egeltje/sousvide-cooker/README.md

sousvide-cooker
===============

AVR atmega32 code for controlling a sous vide cooker. See http://www.ewak.net/blog/sous-vide-cooker/

NOTE: This code is no longer updated, since I got an Anova sous-vide cooker. This satisfies my needs for a cooker and I am no longer building my own.
