egeltje/sousvide-cooker/3d/sous-vide-display.stl

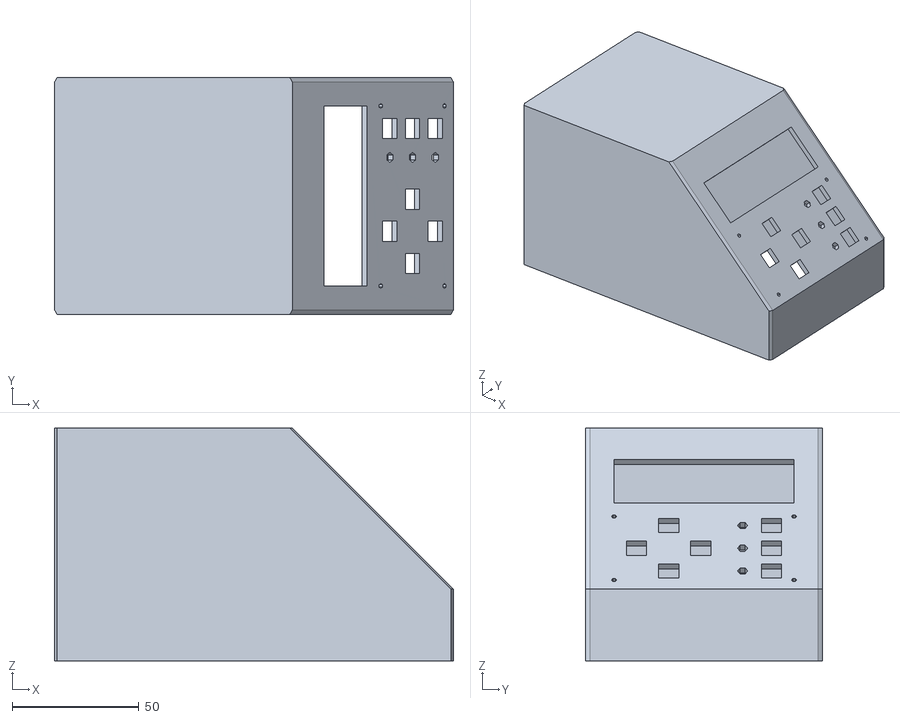
[picture p1: CAD file, 2014-01-03]
3d/sous-vide-display.stl
157.6 x 93.5 x 92.0
