egeltje/sousvide-cooker/3d/sous-vide-plug.stl

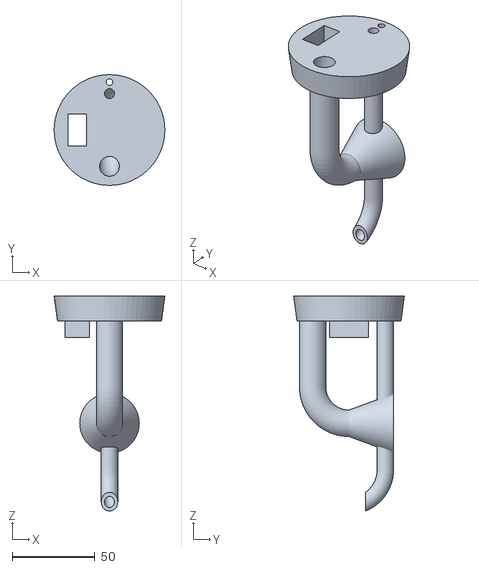
[picture p2: CAD file, 2014-01-01]
3d/sous-vide-plug.stl
67.0 x 67.0 x 130.0
