egeltje/sousvide-cooker/schematics/sous-vide_connect.brd

## EAGLE design schematics/sous-vide_connect.brd (2015-05-28)

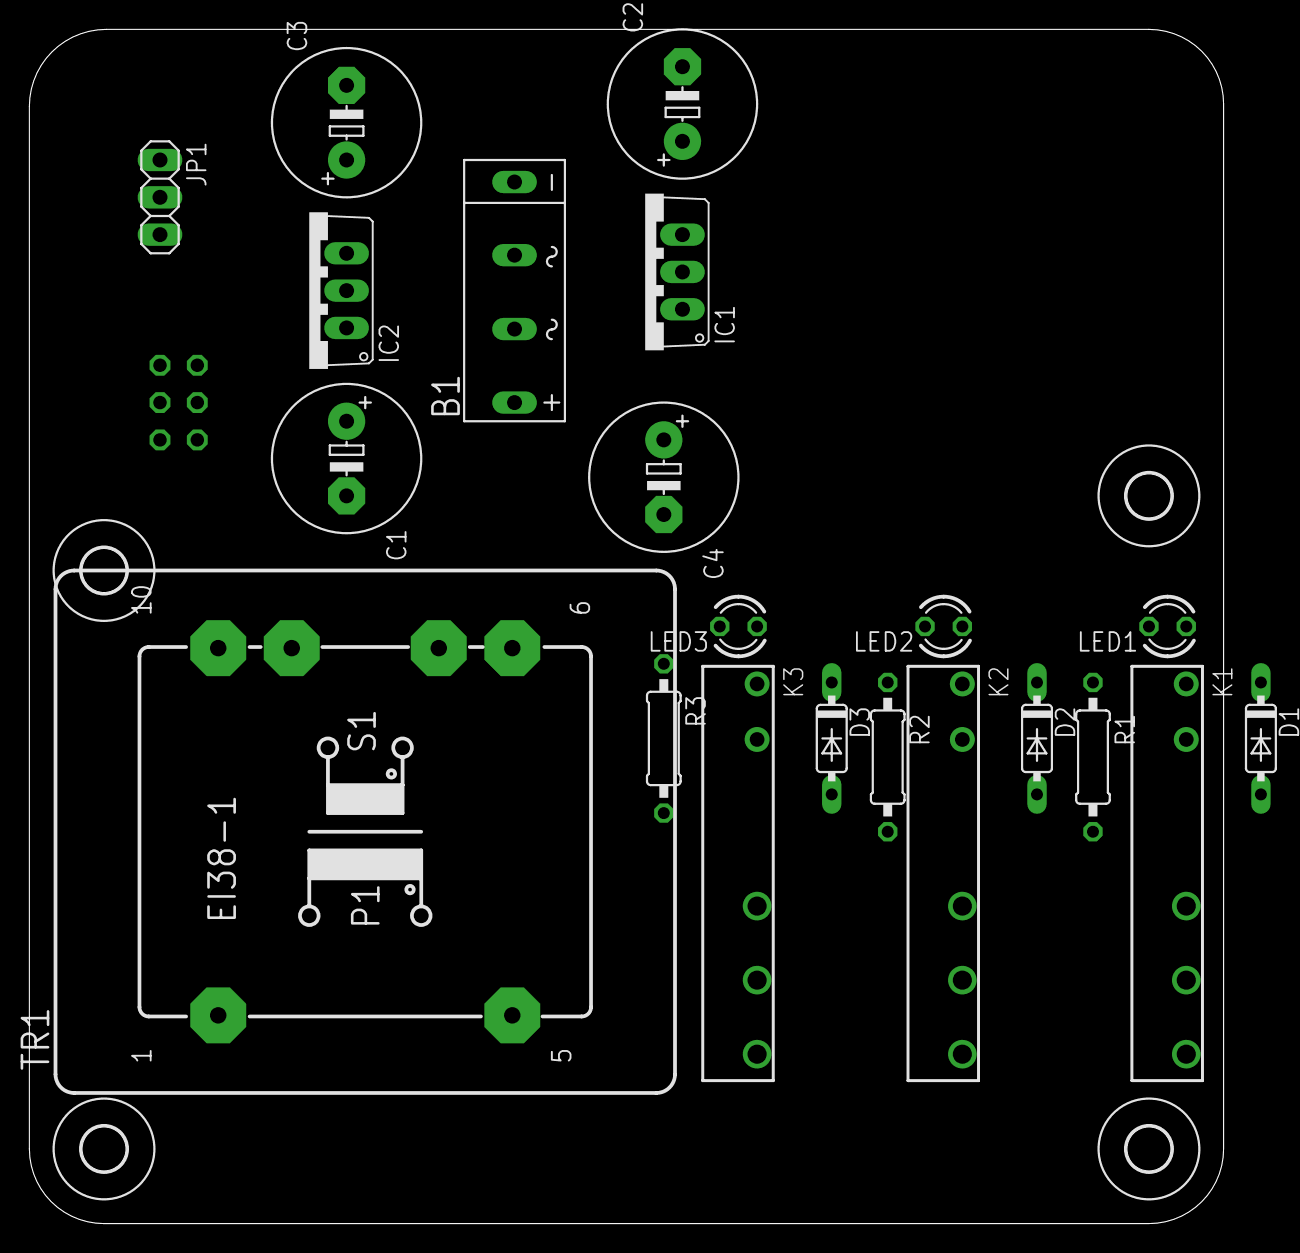
[picture p3: board sous-vide_connect.brd from above]

Board: 2 copper layers, 81.3 x 81.3 mm, 26 parts (1 on the bottom side), 13 nets, no tracks yet.

Parts:
B1: 2KBB-R
C1, C2, C3, C4: E5-10,5
D1, D2, D3: 1N4148DO35-7; DO35-7
H1, H2, H3, H4: MOUNT-HOLE3.0; 3,0
IC1, IC2: 7805TV; TO220V
JP1: 1X03
K1, K2, K3: APF30212C
LED1, LED2, LED3: LED3MM
R1, R2, R3: 0207/10
SV1: ML6
TR1: EI38-1

Connections:
GND: B1.-, C1.-, C2.-, C3.-, C4.-, D1.A, D2.A, D3.A, IC1.2, IC2.2, JP1.3, K1.2, K2.2, K3.2, R1.2, R2.2, R3.2, SV1.6
unnamed: B1.AC1, TR1.9
unnamed: B1.AC2, TR1.7
unnamed: D1.C, K1.1, LED1.A, SV1.1
unnamed: B1.+, C1.+, C4.+, IC1.1, IC2.1
unnamed: JP1.2, SV1.4
unnamed: LED1.K, R1.1
unnamed: LED2.K, R2.1
unnamed: D2.C, K2.1, LED2.A, SV1.3
unnamed: D3.C, K3.1, LED3.A, SV1.5
unnamed: LED3.K, R3.1
unnamed: C2.+, IC1.3
VCC: C3.+, IC2.3, JP1.1, SV1.2
