egeltje/sousvide-cooker/schematics/sous-vide.brd

## EAGLE design schematics/sous-vide.brd (2015-04-16)

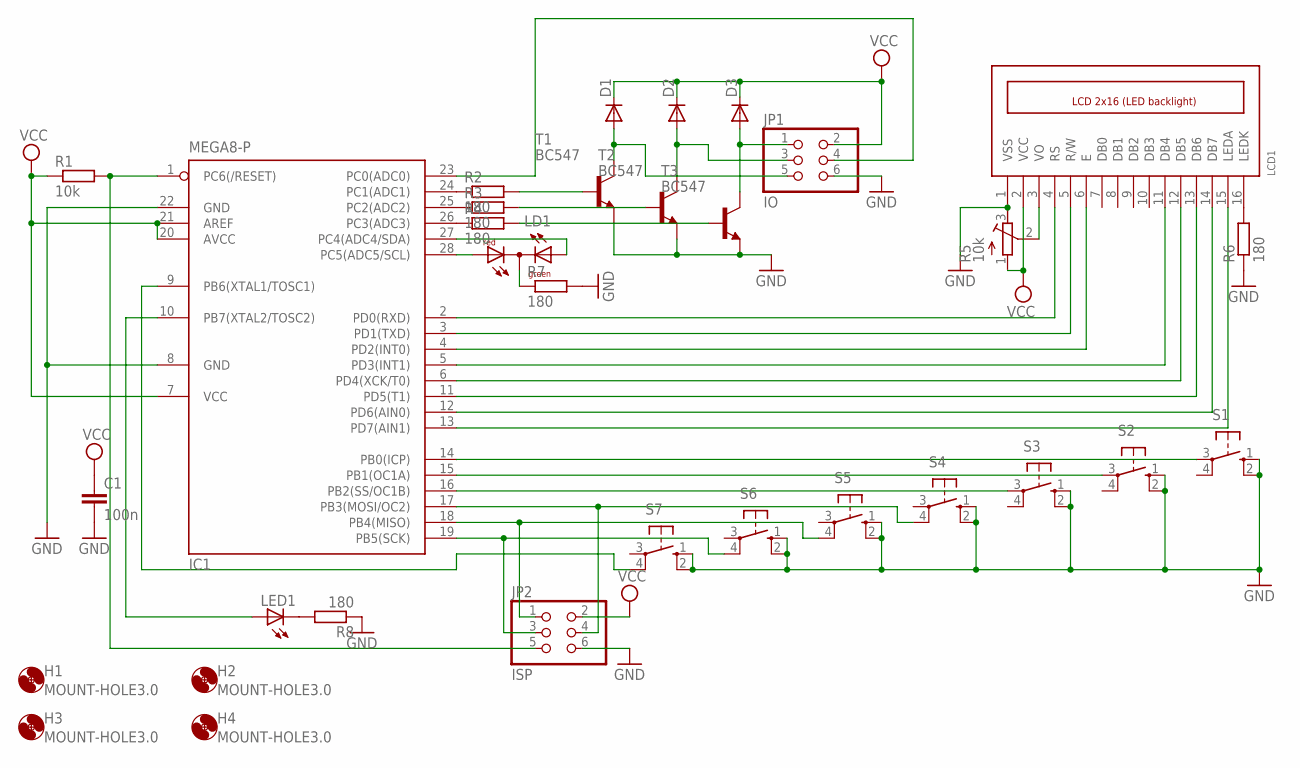
[picture p4: schematic sous-vide.sch]

Parts:
C1: 100n; C025-025X050
D1, D2, D3: DIODE-D-2.5; D-2.5
H1, H2, H3, H4: MOUNT-HOLE3.0; 3,0
IC1: MEGA8-P; DIL28-3
JP1: IO; 2X03
JP2: ISP; 2X03
LCD1: LCD_2X16_SIL; HY-1602F
LD1: DUOLED-RG-C; DUOLED-C-5MM
LED1: LED3MM
R1: 10k; 0207/2V
R2, R3, R4, R6, R7, R8: 180; 0207/2V
R5: 10k; RTRIM3339P
S1, S2, S3, S4, S5, S6, S7: 40-XX; B3F-40XX
T1, T2, T3: BC547; TO92

Connections:
GND: C1.2, IC1.8 (GND), IC1.22 (GND), JP1.6, JP2.6, LCD1.1 (VSS), R5.3 (A), R6.1, R7.2, R8.1, S1.1 (S), S1.2 (S1), S2.1 (S), S2.2 (S1), S3.1 (S), S3.2 (S1), S4.1 (S), S4.2 (S1), S5.1 (S), S5.2 (S1), S6.1 (S), S6.2 (S1), S7.1 (S), S7.2 (S1), T1.1 (E), T2.1 (E), T3.1 (E)
unnamed: LED1.K (C), R8.2
unnamed: LCD1.16 (LEDK), R6.2
unnamed: IC1.23 (PC0(ADC0)), JP1.4
unnamed: IC1.24 (PC1(ADC1)), R2.1
unnamed: IC1.25 (PC2(ADC2)), R3.1
unnamed: IC1.26 (PC3(ADC3)), R4.1
unnamed: LD1.C, R7.1
unnamed: IC1.28 (PC5(ADC5/SCL)), LD1.AR
unnamed: IC1.27 (PC4(ADC4/SDA)), LD1.AX (AG)
unnamed: R2.2, T1.2 (B)
unnamed: R3.2, T2.2 (B)
unnamed: R4.2, T3.2 (B)
unnamed: D1.A, JP1.5, T1.3 (C)
unnamed: LCD1.3 (VO), R5.2 (S)
unnamed: IC1.10 (PB7(XTAL2/TOSC2)), LED1.A
unnamed: D2.A, JP1.3, T2.3 (C)
unnamed: D3.A, JP1.1, T3.3 (C)
unnamed: IC1.19 (PB5(SCK)), JP2.3, S6.4 (P1)
unnamed: IC1.18 (PB4(MISO)), JP2.1, S5.4 (P1)
unnamed: IC1.2 (PD0(RXD)), LCD1.4 (RS)
unnamed: IC1.3 (PD1(TXD)), LCD1.5 (R/W)
unnamed: IC1.4 (PD2(INT0)), LCD1.6 (E)
unnamed: IC1.17 (PB3(MOSI/OC2)), JP2.4, S4.4 (P1)
unnamed: IC1.9 (PB6(XTAL1/TOSC1)), S7.4 (P1)
unnamed: IC1.5 (PD3(INT1)), LCD1.11 (DB4)
unnamed: IC1.6 (PD4(XCK/T0)), LCD1.12 (DB5)
unnamed: IC1.1 (PC6(/RESET)), JP2.5, R1.2
unnamed: IC1.11 (PD5(T1)), LCD1.13 (DB6)
unnamed: IC1.12 (PD6(AIN0)), LCD1.14 (DB7)
unnamed: IC1.13 (PD7(AIN1)), LCD1.15 (LEDA)
unnamed: IC1.16 (PB2(SS/OC1B)), S3.3
unnamed: IC1.14 (PB0(ICP)), S1.3
unnamed: IC1.15 (PB1(OC1A)), S2.3
VCC: C1.1, D1.C, D2.C, D3.C, IC1.7 (VCC), IC1.20 (AVCC), IC1.21 (AREF), JP1.2, JP2.2, LCD1.2 (VCC), R1.1, R5.1 (E)

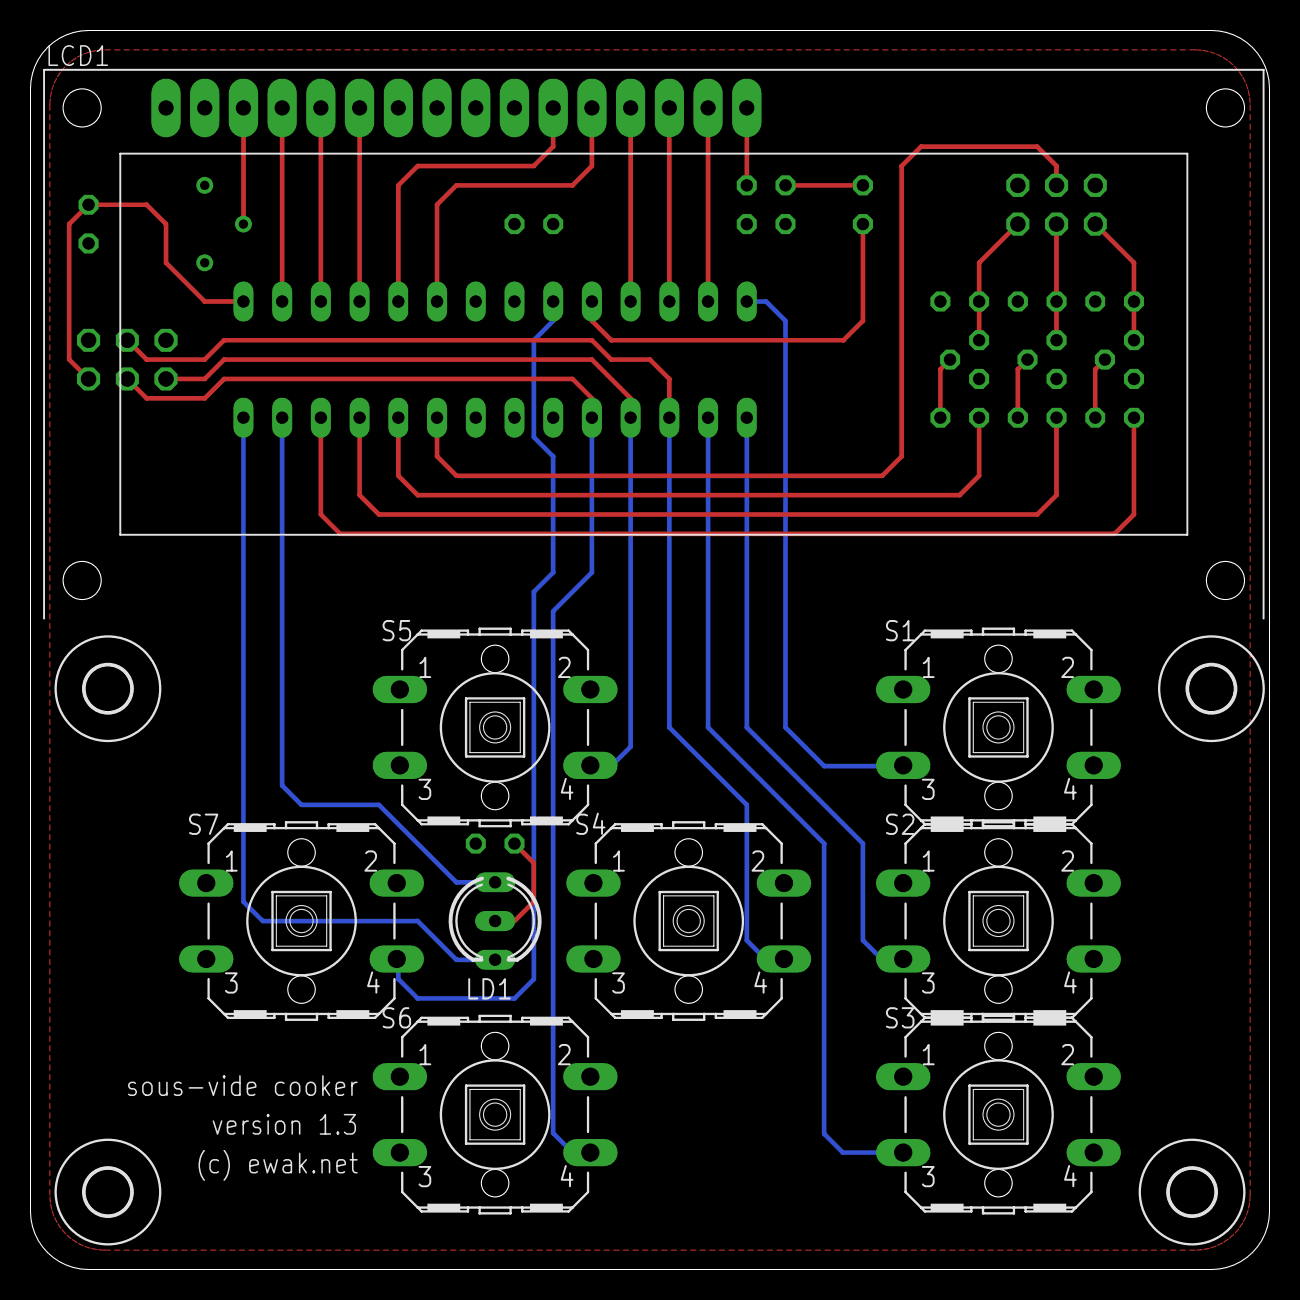
[picture p5: board sous-vide.brd from above]

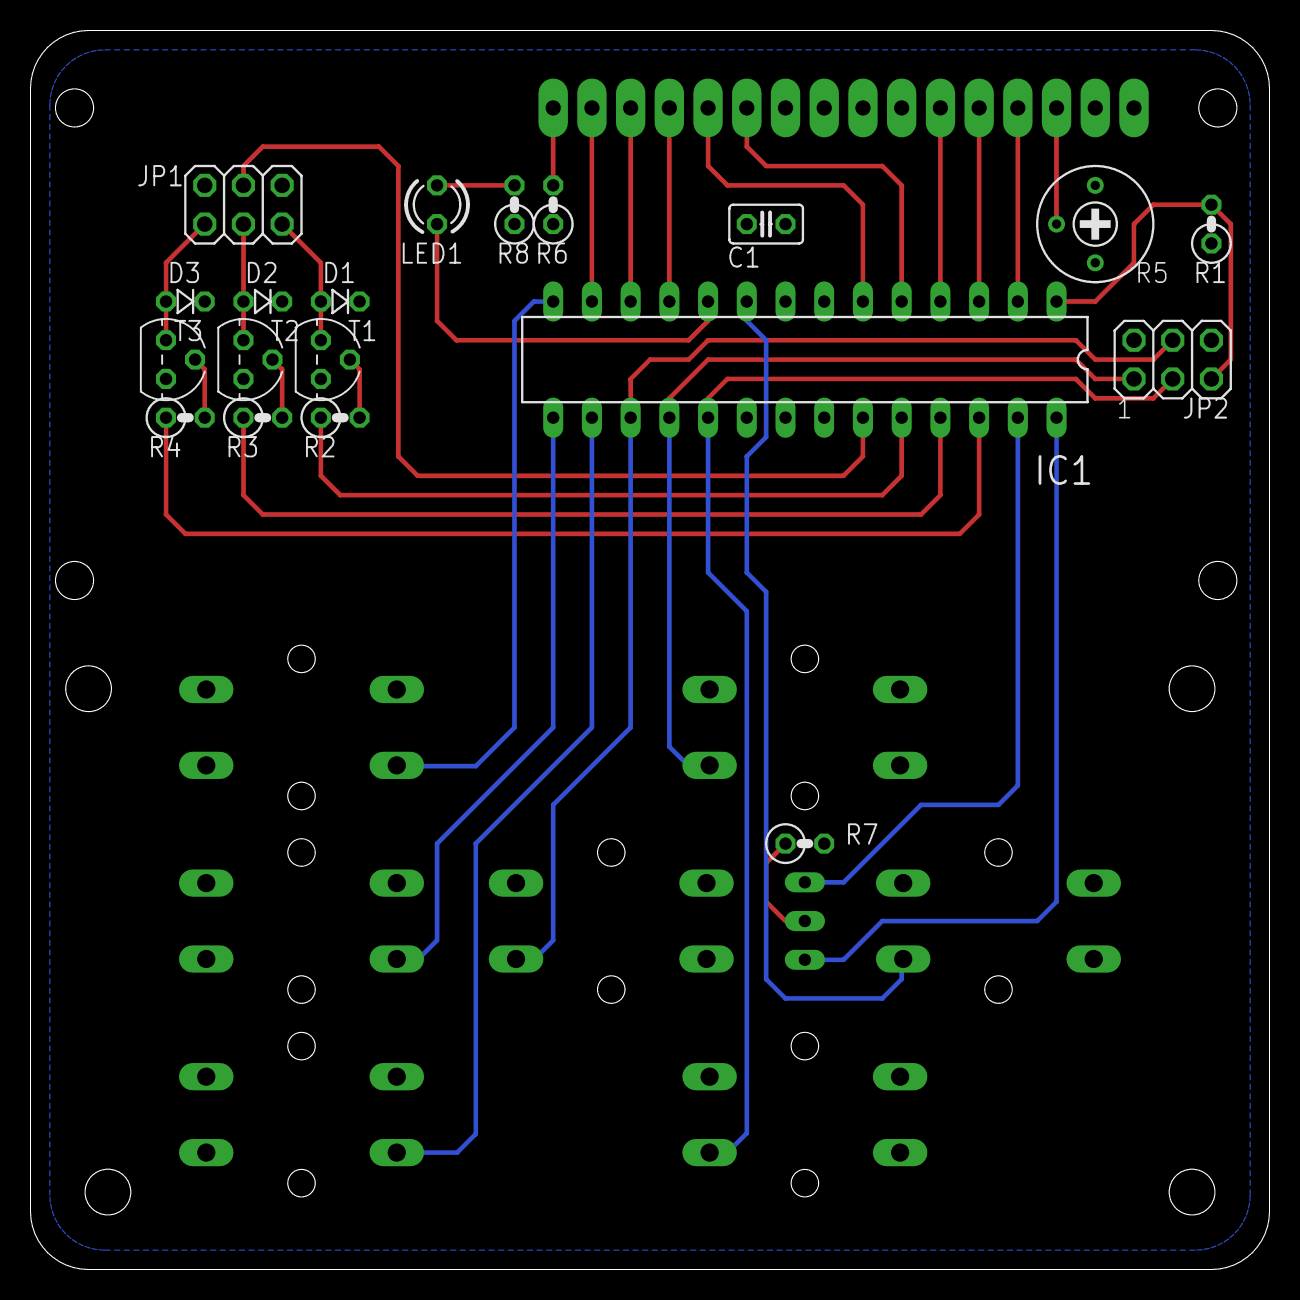
[picture p6: board sous-vide.brd from below]

Board: 2 copper layers, 81.3 x 81.3 mm, 32 parts (19 on the bottom side), 35 nets.
