egeltje/sousvide-cooker/(commit log)

2013-12-29 Electronic schema and board updated
    Created an 8x8 cm board for cpu, display and buttons.
    [sous-vide.brd, sous-vide.sch]
2014-01-01 Added 3d designs for plug
    Added 3d designs for the plug holding the heater, pump and sensor.
    [sous-vide-plug.scad, sous-vide-plug.stl]
2014-01-03 Added 3d designs for display
    First design for case. Plug will be connected to the bottom. Needs
    compartiment for mains voltage stuff.
    [sous-vide-display.scad, sous-vide-display.stl]
2014-01-17 Bug fixes and display change
    Erroneous comment-start removed, Pump and Heater place on display
    swapped.
2014-04-02 Optimized PCB
    Optimized PCB with easier traces for buttons.
    [sous-vide.brd, sous-vide.sch]
2014-04-27 initial steps to move from at32u4 naar at32
    [sous-vide.brd, sous-vide.sch]
2014-04-27 Working ATmega32 code. JTAG disabled with fuses.
2014-04-27 Working ATmega32 code. JTAG disabled with fuses. Display on PORTC
2014-04-28 Average temp reading + ISP connector
    Temp readings are averaged per second before comparing to the set
    temperature. Added ISP header to board for on-board reprogramming.
    [sous-vide.brd, sous-vide.sch]
2014-04-28 Declared variable
    Forgot to declare variable used for averaging temperature readings.
2014-05-01 Fixed bug that allowed time reset while timer was running.
    [sous-vide.h]
2014-05-01 Updated schematic and PCB
    Now includes 4th led for reading indicator. Moved ISP connector to more
    accessible location.
    [sous-vide.brd, sous-vide.sch]
2014-06-05 Switched to ATmega328 and updated schematics and board.
    [sous-vide.brd, sous-vide.sch]
2014-06-05 Moved R6 on board for symmetry with R1.
    [sous-vide.brd]
2014-06-06 Changed connectors and renumbered parts on schematic and board.
    [sous-vide.brd, sous-vide.sch]
2014-06-06 Minor shift in components.
    [sous-vide.brd]
2014-08-12 minor tweaks in component placement, sent to pcb manufacturer
    [sous-vide.brd, sous-vide.sch]
2015-03-30 Reworked schema and pcb for new buttons and display.
    [sous-vide.brd, sous-vide.sch]
2015-03-30 Minor tweaks before shipping to pcb manufacturer.
    [sous-vide.brd, sous-vide.sch]
2015-04-16 Fixed VCC/VDD/VSS/GND issue with display, renumbered parts, updated port assignment in code.
    [sous-vide.brd, sous-vide.sch]
2015-05-05 Reordered interrupt events, _iTime is still running too fast.
    [config.c, config.h, main.c, main.h]
2015-05-05 Fixed timer issue by placing _iTime++ inside TICK handler.
    [config.h, main.c, main.h]
2015-05-06 Main functions working correctly, next steps are config functions.
    [config.c, config.h, main.c, main.h]
2015-05-08 Menu function with dynamic strings working. Screen not yet updating correctly.
    [config.c, config.h, main.c]
2015-05-08 Submenus working by initializing _iButtonOld with the current iButton value when initializing.
2015-05-08 Steamlined calibration functions.
2015-05-08 Added variable to show the set temperature in fConfigCalibrationMeasurement.
2015-05-15 Solved wrongly updating period (always period 0) by storing the period in a temp variable and using that. Horrible...
    [config.c, main.c, main.h]
2015-05-15 Added temperature calibration and additional confirmation dialog for factory reset.
    [config.c, main.c, main.h]
2015-05-15 Fixed small bug in calculating calibrated temperature reading.
    [config.c, main.c]
2015-05-15 Moved temperature calibration to main loop in stead of interrupt routine.
2015-05-16 Fixed EEPROM reading offset error.
    [config.c, main.c]
2015-05-17 Move to dedicated display functions complete. Last remaining issue is calculating (and using) T(t) for even temperature change over set time.
    [config.c, config.h, display.c, display.h, main.c]
2015-05-19 Completed temperature calculation.
2015-05-28 Started working on connect pcb for transformer and relays.
    [sous-vide_connect.brd, sous-vide_connect.sch]
